Dkenner1/CarConsole/(list of files, cad)

Other CAD files:
Fusion360/ConsoleFrame v17.f3z
Fusion360/MockFrontPanel v5.f3z
