Dkenner1/CarConsole/MultiMediaSystem/Regulator_5V/changelog.txt

Revised Inductor to back side (for upright usage) Rev 1.2
