Dkenner1/CarConsole/MultiMediaSystem/AudioAmp/AudioAmp.kicad_pcb

## KiCad design MultiMediaSystem/AudioAmp/AudioAmp.kicad_pcb (2022-10-20)

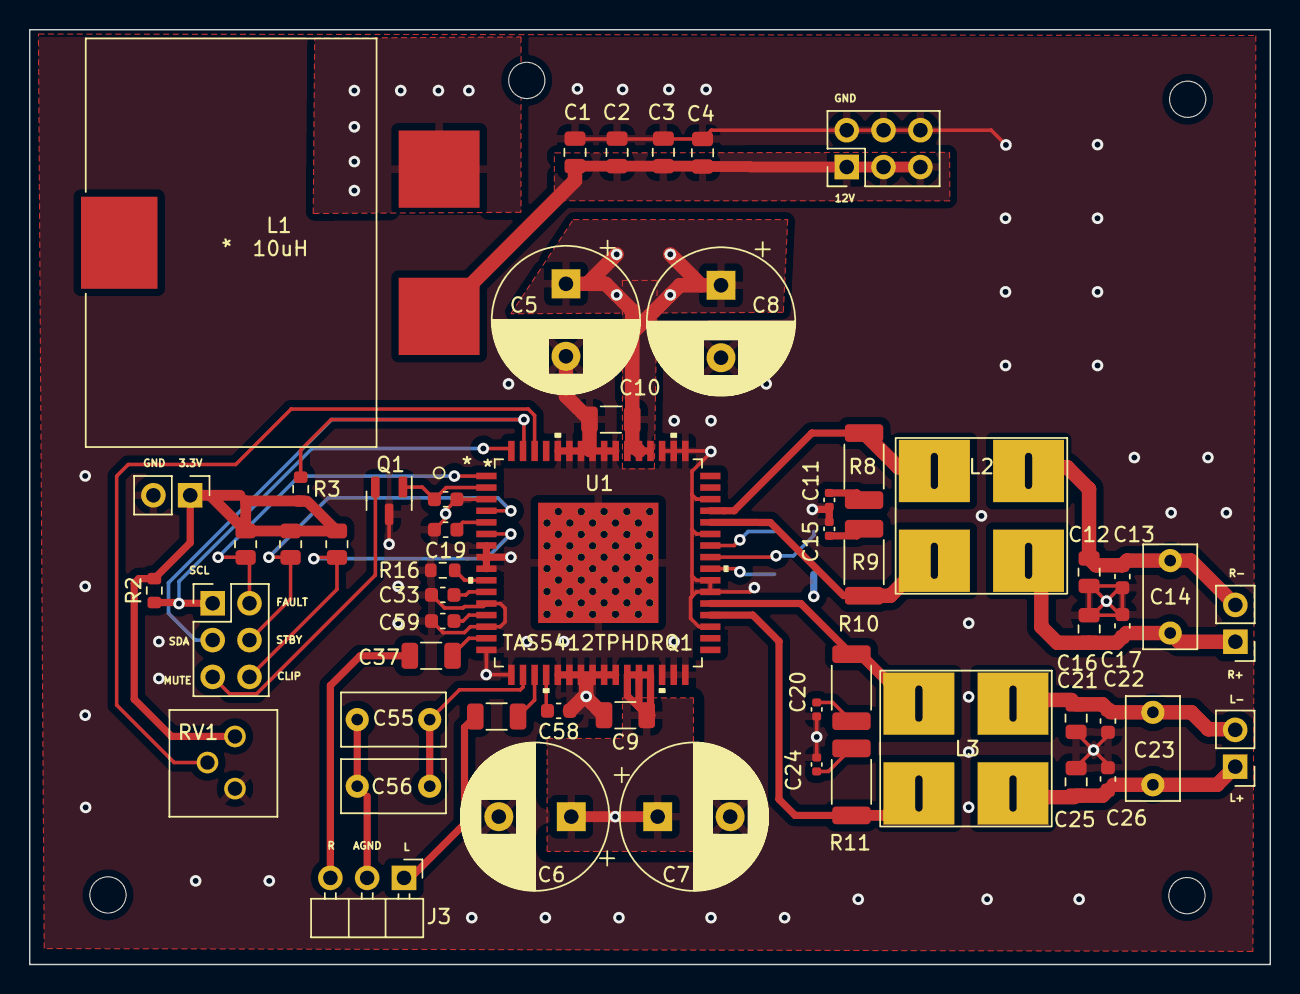
[picture p1: board AudioAmp.kicad_pcb from above]

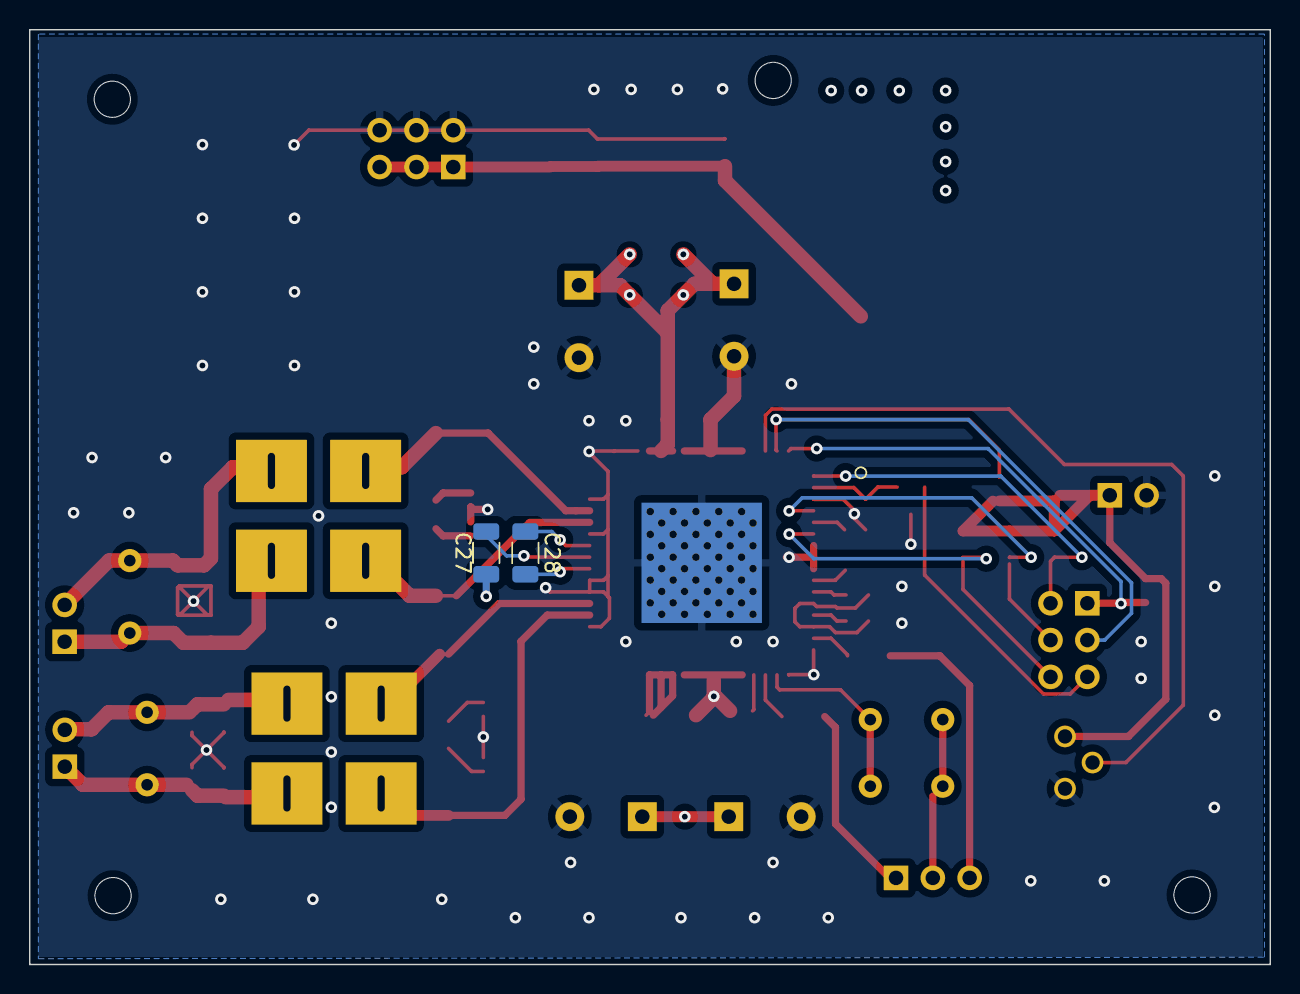
[picture p2: board AudioAmp.kicad_pcb from below]

Board: 4 copper layers, 85.6 x 64.5 mm, 61 parts (2 on the bottom side), 38 nets.

Parts:
C1, C2: 4.7uF; C_0805_2012Metric
C3: 82nF; C_0805_2012Metric
C4: 2.2nF; C_0805_2012Metric
C5, C6, C7, C8: 330uF; CP_Radial_D10.0mm_P5.00mm
C9, C10, C27, C28: 1uF; C_1206_3216Metric
C11, C15, C20, C24: 1nF; C_0402_1005Metric
C12, C16, C21, C25: 470nF; C_0805_2012Metric
C13, C17, C22, C26: 10nF; C_0603_1608Metric
C14, C23, C55, C56: .47uF; C_Rect_L7.0mm_W3.5mm_P5.00mm
C18: 220nF; C_0603_1608Metric
C19, C33, C58, C59: 100nF; C_0603_1608Metric
C37, C39: .47uF; C_1206_3216Metric
H1, H2, H3, H4: MountingHole; MountingHole_2.5mm
J1: Ctrl_pins; PinHeader_2x03_P2.54mm_Vertical
J2: PWR; PinHeader_2x03_P2.54mm_Vertical
J3: AudioIn; PinHeader_1x03_P2.54mm_Horizontal
J4: PULLUP_SRC; PinHeader_1x02_P2.54mm_Vertical
J5: Rspkr_o; PinHeader_1x02_P2.54mm_Vertical
J6: Lspkr_o; PinHeader_1x02_P2.54mm_Vertical
L1: 10uH; SER2918H-103KL
L2, L3: 10uH; JA4575-AL
Q1: q; SOT-23
R2, R3: 4.7K; R_0603_1608Metric
R5, R6, R7: 49.9K; R_0805_2012Metric
R8, R9, R10, R11: 5.6; R_2010_5025Metric
R16: 20k; R_0603_1608Metric
RV1: 50K pot; CT-6EW
U1: TAS5412TPHDRQ1

Connections:
+3V3: J4.1, R2.2, R3.2, R5.2, R6.2, R7.2, RV1.1
+12V: C1.1, C2.1, C3.1, C4.1, J2.1, J2.3, J2.5, L1.1
AudioGND: C55.1, C56.1, J3.2
CLIP_OTW: J1.6, R7.1, U1.6 (*CLIP_OTW)
CP: C27.2, U1.41 (CP)
CPC_TOP: C28.1, U1.42 (CPC_TOP)
CP_BOT: C28.2, U1.40 (CP_BOT)
FAULT: J1.2, R5.1, U1.1 (*FAULT)
GND: C1.2, C2.2, C3.2, C4.2, C5.2, C6.2, C7.2, C8.2, C9.2, C10.2, C11.1, C12.1, C13.1, C15.2, C16.2, C17.2, C18.2, C19.2, C20.1, C21.1, C22.1, C24.2, C25.2, C26.2, C33.2, C58.1, C59.2, J2.2, J2.4, J2.6, J4.2, Q1.3 (S), R16.1, RV1.3, U1.3 (GND), U1.7 (GND), U1.8 (GND), U1.9 (GND), U1.12 (GND), U1.14 (GND), U1.16 (GND), U1.17 (GND), U1.21 (GND), U1.22 (GND), U1.23 (GND), U1.24 (GND), U1.25 (GND), U1.26 (GND), U1.30 (GND), U1.31 (GND), U1.32 (GND), U1.35 (GND), U1.38 (GND), U1.39 (GND), U1.43 (GND), U1.46 (GND), U1.49 (GND), U1.50 (GND), U1.51 (GND), U1.55 (GND), U1.56 (GND), U1.57 (GND), U1.58 (GND), U1.59 (GND), U1.60 (GND), U1.EPAD
I2C_ADDR: RV1.2, U1.62 (I2C_ADDR)
IN1_P: C37.2, U1.15 (IN1_P)
IN2_P: C39.2, U1.19 (IN2_P)
IN_M: C55.2, C56.2, U1.18 (IN_M)
L: C39.1, J3.1
L_o+: C23.2, C25.1, C26.1, J6.1, L3.3
L_o-: C21.2, C22.2, C23.1, J6.2, L3.2
MUTE: J1.5, Q1.2 (G)
MUTE*: C18.1, Q1.1 (D), U1.2 (*MUTE)
unnamed: C11.2, R8.2
unnamed: C15.1, R9.1
unnamed: C19.1, U1.5 (D_BYP)
unnamed: C20.2, R10.2
unnamed: C24.1, R11.1
unnamed: C33.1, U1.11 (A_BYP)
unnamed: C58.2, U1.20 (CM_CAP2)
unnamed: C59.1, U1.13 (CM_CAP1)
unnamed: R16.2, U1.10 (REXT)
OUT1_M: L2.1, R8.1, U1.45 (OUT1_M)
OUT1_P: L2.4, R9.2, U1.44 (OUT1_P)
OUT2_M: L3.1, R10.1, U1.37 (OUT2_M)
OUT2_P: L3.4, R11.2, U1.36 (OUT2_P)
PVDD: C5.1, C6.1, C7.1, C8.1, C9.1, C10.1, C27.1, L1.2, U1.27 (PVDD), U1.28 (PVDD), U1.29 (PVDD), U1.52 (PVDD), U1.53 (PVDD), U1.54 (PVDD)
R: C37.1, J3.3
R_o+: C14.2, C16.1, C17.1, J5.1, L2.3
R_o-: C12.2, C13.2, C14.1, J5.2, L2.2
SCL: J1.1, R2.1, U1.64 (SCL)
SDA: J1.3, R3.1, U1.63 (SDA)
STANDBY: J1.4, R6.1, U1.4 (*STANDBY)
