Dkenner1/CarConsole/MultiMediaSystem/Motherboard/Motherboard.kicad_pcb

## KiCad design MultiMediaSystem/Motherboard/Motherboard.kicad_pcb (2022-10-20)

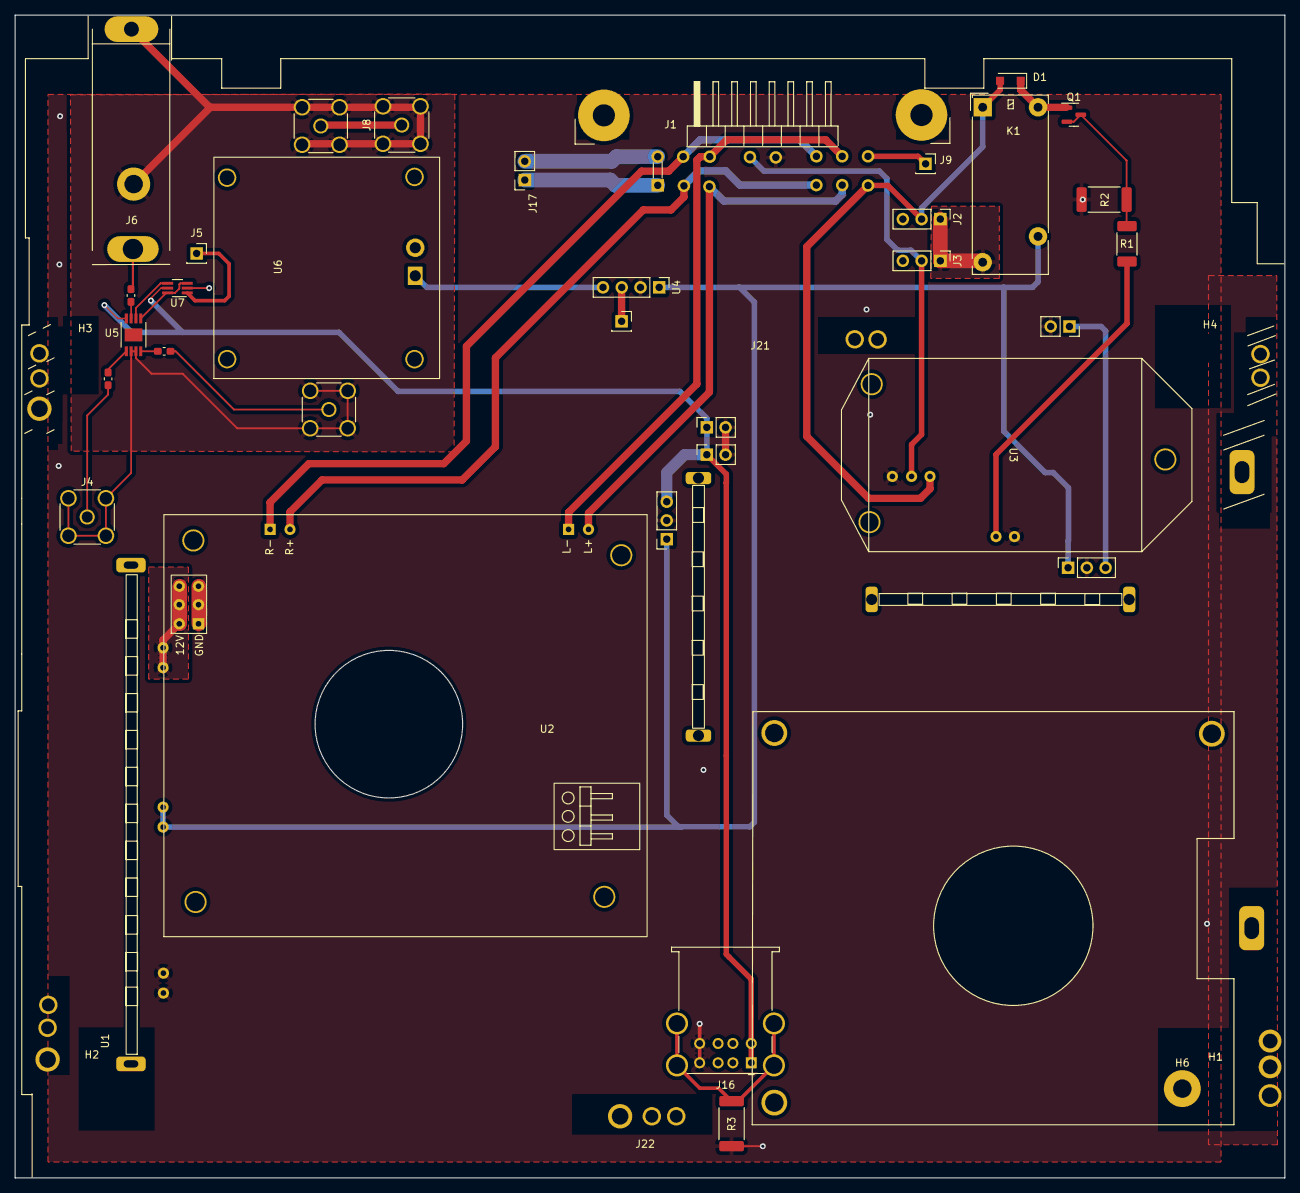
[picture p3: board Motherboard.kicad_pcb from above]

Board: 2 copper layers, 172.1 x 157.6 mm, 42 parts (0 on the bottom side), 32 nets.

Parts:
C1, C2, C3: 10uF; C_0603_1608Metric_Pad1.08x0.95mm_HandSolder
D1: FS1B; D_SOD-123F
H1, H2, H3, H4: MountingHole; RectangleSlot
H5, H6, H7, H8: DAC_mount; MountingHole_2.5mm_Pad
J1: Wire Harness; HeadUnit_Conn
J2: Vmem Jumper; PinHeader_1x03_P2.54mm_Vertical
J3: Vacc_jumper; PinHeader_1x03_P2.54mm_Vertical
J4: RF_RX; SMA_Amphenol_132134_Vertical
J5: RF_CTRL; PinSocket_1x01_P2.54mm_Vertical
J6: AntennaExternal; SubaruRadioJack
J8: RF_TX; SMA_Amphenol_132134_Vertical
J9: AntennaPwr_Conn; PinSocket_1x01_P2.54mm_Vertical
J10: RF_EN; PinSocket_1x01_P2.54mm_Vertical
J14: 5V_1; PinSocket_1x02_P2.54mm_Vertical
J15: RPI_Buck; 5V_Reg_Footprint_VertMnt
J16: AUSB2-4599; USB_A_Wuerth_61400826021_Horizontal_Stacked
J17: Illum/Dim; PinSocket_1x02_P2.54mm_Vertical
J18: 5V_2; PinSocket_1x02_P2.54mm_Vertical
J19: GP_Buck; 5V_Reg_Footprint_VertMnt
J20: 5V_3; PinSocket_1x02_P2.54mm_Vertical
J21: Motherboard bracket; MotherBoard_Bracket_2
J22: Motherboard bracket; MotherBoard_Bracket_1
K1: ADW1112HTW; Relay_1P1T_NO_10x24x18.8mm_Panasonic_ADW11xxxxW_THT
Q1: T2N7002BK,LM; SOT-23
R1: RMCP2010FT470R; R_2010_5025Metric_Pad1.40x2.65mm_HandSolder
R2: RC2512JK-0747KL; R_2512_6332Metric_Pad1.40x3.35mm_HandSolder
R3: HCJ2512ZT0R00; R_2512_6332Metric_Pad1.40x3.35mm_HandSolder
U1: AudioAmp_PS
U2: AudioAmp
U3: PowerSupplyCtrl; PS_Controller
U4: RadioRegulator; PinHeader_1x04_P2.54mm_Vertical
U5: HMC784AMS8GETR
U6: RadioAmp
U7: SN74LVC2G06QDCKRQ1; SOT-363_SC-70-6_Handsoldering

Connections:
5V: J14.1, J15.3
5V_GP: J16.1 (VBUS1), J16.5 (VBUS2), J18.1, J19.3, J20.1, U5.4 (VDD), U7.5 (VCC)
8V: U4.4 (Vradio), U6.1 (Vsrc)
Antenna: C1.1, J6.1 (In)
Antenna_Pwr: J1.14, J9.1
AudioPwr: U1.3 (Vout), U2.1 (12V)
Dim: J1.7, J17.2
FrontSpkr_L+: J1.3, J1.5, U2.5 (L+)
FrontSpkr_L-: J1.9, J1.13, U2.6 (L-)
FrontSpkr_R+: J1.2, J1.4, U2.3 (R+)
FrontSpkr_R-: J1.8, J1.12, U2.4 (R-)
GND: J1.11, J14.2, J15.2, J16.4 (GND1), J16.8 (GND2), J18.2, J19.2, J20.2, R2.1, R3.1, U1.2 (GND), U2.2 (GND), U3.3 (GND), U4.2 (GND), U6.2 (GND), U7.2 (GND)
Illum: J1.1, J17.1
unnamed: C1.2, U5.3 (RFC)
unnamed: C2.1, U5.5 (RF1)
unnamed: C3.1, U5.8 (RF2)
unnamed: D1.1 (K), K1.6, Q1.1 (D)
unnamed: J16.9 (Shield), R3.2
unnamed: Q1.2 (G), Q1.3 (S), R1.2, R2.2
RELAY: R1.1, U3.6 (SWITCH)
RF_A: U5.1 (A), U7.3 (2A), U7.6 (1Y)
RF_ATX: C3.2, U6.5 (out)
RF_B: U5.2 (B), U7.4 (2Y)
RF_CTL: J5.1, U7.1 (1A)
RF_RX: C2.2, J4.1 (In)
RF_TX: J8.1 (In), U6.3 (in)
RF_gnd: J4.2 (Ext), J6.2 (Ext), J8.2 (Ext), U5.6 (GND), U5.7 (GND), U6.4 (in_gnd), U6.6 (out_gnd)
Radio_EN: J10.1, U4.3 (EN)
Vacc: J1.10, J3.2, U3.2 (Vmes)
Vdd: J2.1, J3.1, K1.3
Vmem: D1.2 (A), J1.6, J2.2, K1.1, U3.1 (Vin)
Vsrc: J15.1, J19.1, K1.5, U1.1 (Vin), U4.1 (Vsrc)
