Dkenner1/CarConsole/MultiMediaSystem/StereoPS/StereoPS_SMD_REV/StereoPS_SMD_REV.kicad_pcb

## KiCad design MultiMediaSystem/StereoPS/StereoPS_SMD_REV/StereoPS_SMD_REV.kicad_pcb (2022-10-20)

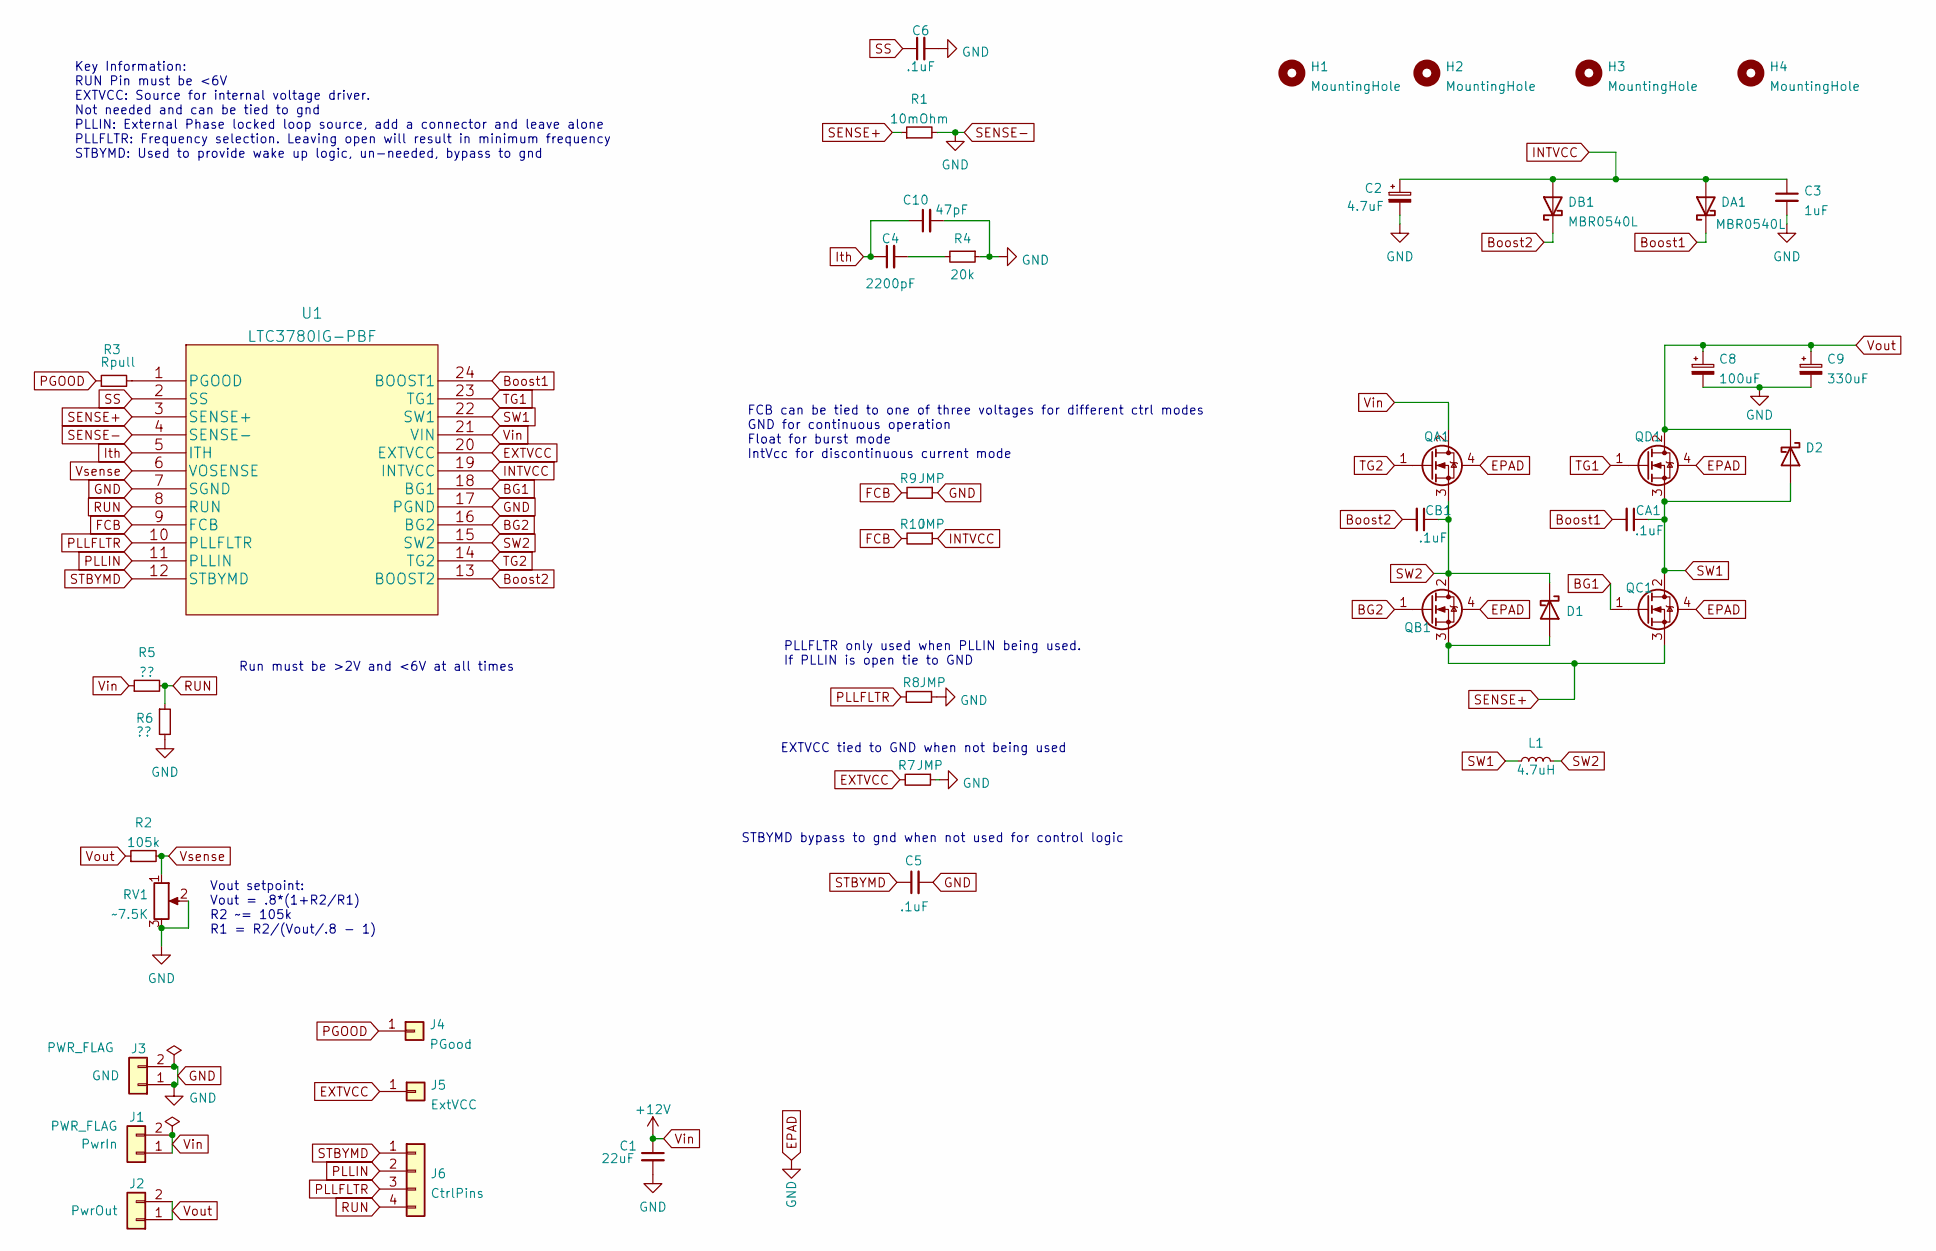
[picture p4: schematic StereoPS_SMD_REV.kicad_sch, LTC3780 Audio Amplifier Voltage Regulator]

Parts:
C1: 22uF; C_1206_3216Metric_Pad1.33x1.80mm_HandSolder
C2: 4.7uF; C_0805_2012Metric_Pad1.18x1.45mm_HandSolder
C3: 1uF; C_1206_3216Metric_Pad1.33x1.80mm_HandSolder
C4: 2200pF; C_0805_2012Metric_Pad1.18x1.45mm_HandSolder
C5, C6: .1uF; C_0603_1608Metric_Pad1.08x0.95mm_HandSolder
C8: 100uF; CP_Radial_D8.0mm_P3.50mm
C9: 330uF; CP_Radial_D10.0mm_P5.00mm
C10: 47pF; C_0603_1608Metric_Pad1.08x0.95mm_HandSolder
CA1: .1uF; C_0603_1608Metric_Pad1.08x0.95mm_HandSolder
CB1: .1uF; C_0603_1608Metric_Pad1.08x0.95mm_HandSolder
D1: SS34-E3; D_SOD-123
D2: SS32-E3; D_SOD-123
DA1: MBR0540L; D_SOD-123
DB1: MBR0540L; D_SOD-123
H1, H2, H3, H4: MountingHole; MountingHole_2.5mm
J1: PwrIn; PinHeader_1x02_P2.54mm_Horizontal
J2: PwrOut; PinHeader_1x02_P2.54mm_Horizontal
J3: GND; PinHeader_1x02_P2.54mm_Horizontal
J4: PGood; PinSocket_1x01_P2.54mm_Vertical
J5: ExtVCC; PinSocket_1x01_P2.54mm_Vertical
J6: CtrlPins; PinSocket_1x04_P2.54mm_Vertical
L1: 4.7uH; L_12x12mm_H8mm
QA1: RX3G07CGNC16; MSOP-8-1EP_3x3mm_P0.65mm_EP1.73x1.85mm
QB1: RX3G07CGNC16; MSOP-8-1EP_3x3mm_P0.65mm_EP1.73x1.85mm
QC1: RX3G07CGNC16; MSOP-8-1EP_3x3mm_P0.65mm_EP1.73x1.85mm
QD1: RX3G07CGNC16; MSOP-8-1EP_3x3mm_P0.65mm_EP1.73x1.85mm
R1: 10mOhm; R_0402_1005Metric_Pad0.72x0.64mm_HandSolder
R2: 105k; R_1206_3216Metric_Pad1.30x1.75mm_HandSolder
R3: Rpull; R_0805_2012Metric_Pad1.20x1.40mm_HandSolder
R4: 20k; R_1206_3216Metric_Pad1.30x1.75mm_HandSolder
R5, R6: ??; R_0805_2012Metric_Pad1.20x1.40mm_HandSolder
R7, R8, R9, R10: JMP; R_0805_2012Metric_Pad1.20x1.40mm_HandSolder
RV1: ~7.5K; CT-6EW
U1: LTC3780IG-PBF

Connections:
BG1: QC1.1 (G), U1.18 (BG1)
BG2: QB1.1 (G), U1.16 (BG2)
Boost1: CA1.2, DA1.1 (K), U1.24 (BOOST1)
Boost2: CB1.2, DB1.1 (K), U1.13 (BOOST2)
EPAD: C1.2, C2.2, C3.2, C5.2, C6.2, C8.2, C9.2, C10.2, J3.1, J3.2, QA1.4 (EPAD), QB1.4 (EPAD), QC1.4 (EPAD), QD1.4 (EPAD), R1.2, R4.1, R6.2, R7.1, R8.1, R9.1, RV1.2, RV1.3, U1.4 (SENSE-), U1.7 (SGND), U1.17 (PGND)
EXTVCC: J5.1, R7.2, U1.20 (EXTVCC); also elsewhere on the board
FCB: R9.2, R10.2, U1.9 (FCB)
INTVCC: C2.1, C3.1, DA1.2 (A), DB1.2 (A), R10.1, U1.19 (INTVCC)
Ith: C4.1, C10.1, U1.5 (ITH)
unnamed: C4.2, R4.2
unnamed: R3.2, U1.1 (PGOOD)
PGOOD: J4.1, R3.1
PLLFLTR: J6.3, R8.2, U1.10 (PLLFLTR)
PLLIN: J6.2, U1.11 (PLLIN)
RUN: J6.4, R5.2, R6.1, U1.8 (RUN)
SENSE+: D1.2 (A), QB1.3 (S), QC1.3 (S), R1.1, U1.3 (SENSE+)
SS: C6.1, U1.2 (SS)
STBYMD: C5.1, J6.1, U1.12 (STBYMD)
SW1: CA1.1, D2.2 (A), L1.1, QC1.2 (D), QD1.3 (S), U1.22 (SW1)
SW2: CB1.1, D1.1 (K), L1.2, QA1.3 (S), QB1.2 (D), U1.15 (SW2)
TG1: QD1.1 (G), U1.23 (TG1)
TG2: QA1.1 (G), U1.14 (TG2)
Vin: C1.1, J1.1, J1.2, QA1.2 (D), R5.1, U1.21 (VIN)
Vout: C8.1, C9.1, D2.1 (K), J2.1, J2.2, QD1.2 (D), R2.1
Vsense: R2.2, RV1.1, U1.6 (VOSENSE)

Notes on the sheet:
Key Information: RUN Pin must be <6V EXTVCC: Source for internal voltage driver. Not needed and can be tied to gnd PLLIN: External Phase locked loop source, add a connector and leave alone PLLFLTR: Frequency selection. Leaving open will result in minimum frequency STBYMD: Used to provide wake up lo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
EXTVCC tied to GND when not being used
Run must be >2V and <6V at all times
FCB can be tied to one of three voltages for different ctrl modes GND for continuous operation Float for burst mode IntVcc for discontinuous current mode
Vout setpoint: Vout = .8*(1+R2/R1) R2 ~= 105k R1 = R2/(Vout/.8 - 1)
PLLFLTR only used when PLLIN being used. If PLLIN is open tie to GND
STBYMD bypass to gnd when not used for control logic

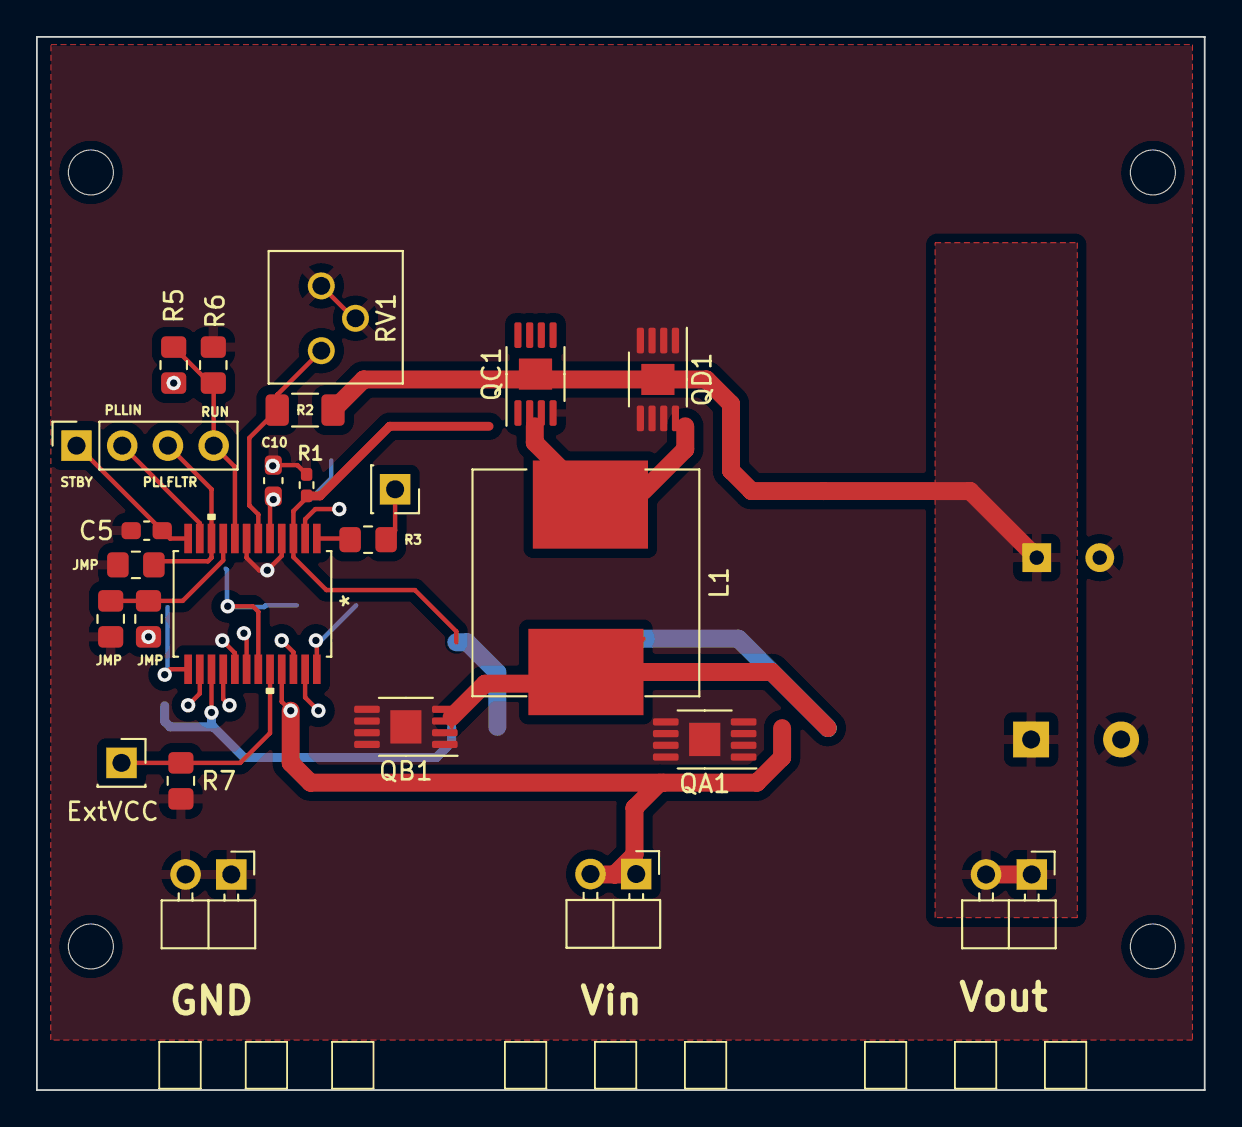
[picture p5: board StereoPS_SMD_REV.kicad_pcb from above]

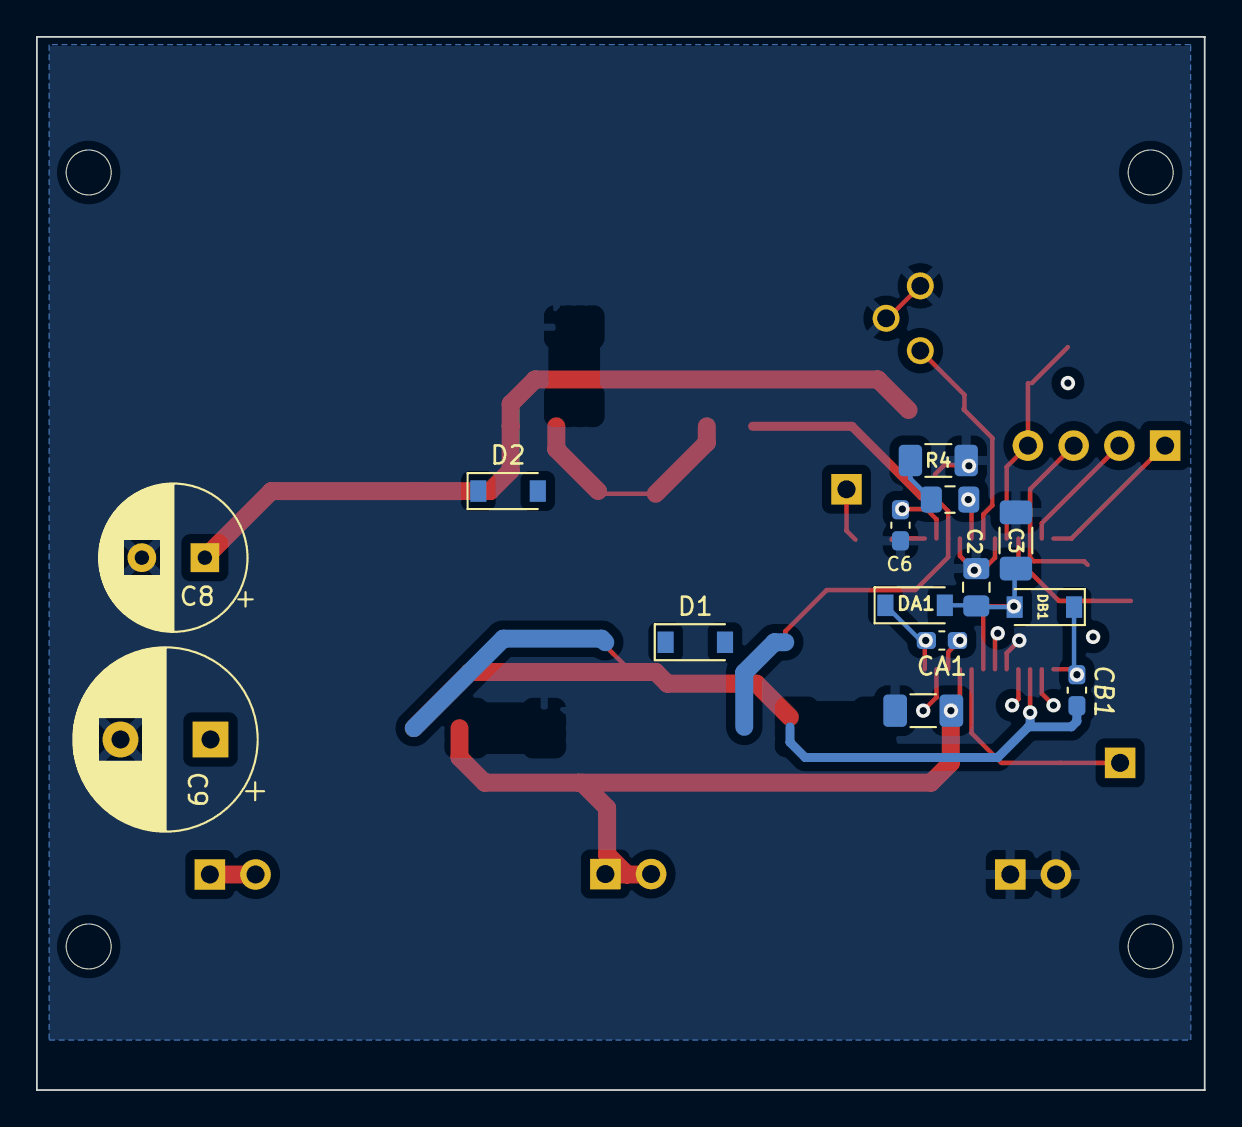
[picture p6: board StereoPS_SMD_REV.kicad_pcb from below]

Board: 4 copper layers, 64.9 x 58.5 mm, 42 parts (14 on the bottom side), 25 nets.

Other parts of the board:
ExtVCC: ExtVCC; PinSocket_1x01_P2.54mm_Vertical

Their connections:
EXTVCC: ExtVCC.1; also elsewhere on the board
