Dkenner1/CarConsole/MultiMediaSystem/StereoPS/StereoPS.kicad_pcb

## KiCad design MultiMediaSystem/StereoPS/StereoPS.kicad_pcb (2022-10-20)

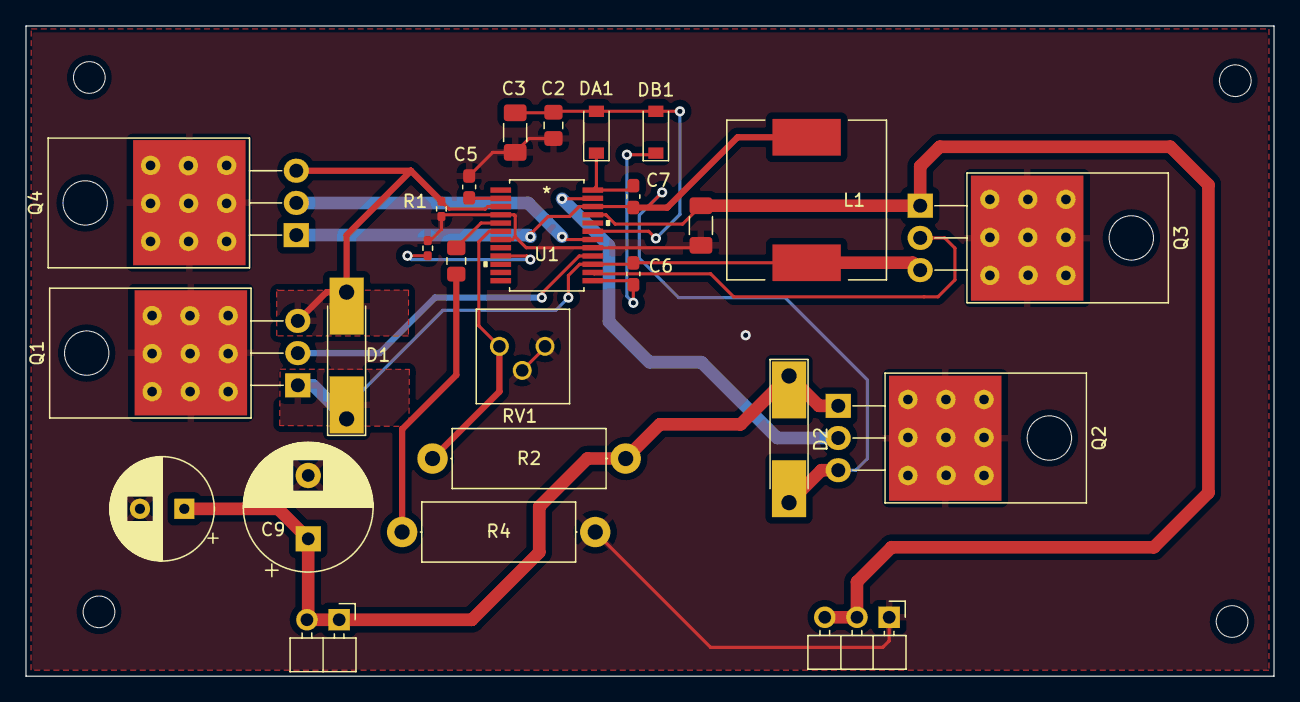
[picture p7: board StereoPS.kicad_pcb from above]

Board: 2 copper layers, 98.5 x 51.3 mm, 30 parts (0 on the bottom side), 18 nets.

Parts:
C1: 22uF; C_1206_3216Metric_Pad1.33x1.80mm_HandSolder
C2: 4.7uF; C_0805_2012Metric_Pad1.18x1.45mm_HandSolder
C3: 1uF; C_1206_3216Metric_Pad1.33x1.80mm_HandSolder
C4: 2200pF; C_0805_2012Metric_Pad1.18x1.45mm_HandSolder
C5, C6, C7: .1uF; C_0603_1608Metric_Pad1.08x0.95mm_HandSolder
C8: 100uF; CP_Radial_D8.0mm_P3.50mm
C9: 330uF; CP_Radial_D10.0mm_P5.00mm
D1: SS34-E3; D_MELF-RM10_Universal_Handsoldering
D2: SS32-E3; D_MELF-RM10_Universal_Handsoldering
DA1: MBR0540L; D_SOD-123
DB1: MBR0540L; D_SOD-123
H1, H2, H3, H4: MountingHole; MountingHole_2.5mm
J1: PwrIn; PinHeader_1x03_P2.54mm_Horizontal
J2: PwrOut; PinHeader_1x02_P2.54mm_Horizontal
L1: 4.7uH; L_12x12mm_H8mm
Q1, Q2, Q3, Q4: RX3G07CGNC16; TO-220-3_Horizontal_TabDown_Thermal
R1: 10mOhm; R_0402_1005Metric_Pad0.72x0.64mm_HandSolder
R2: 105k; R_Axial_DIN0414_L11.9mm_D4.5mm_P15.24mm_Horizontal
R3: 0Ohm; R_0402_1005Metric_Pad0.72x0.64mm_HandSolder
R4: 20k; R_Axial_DIN0414_L11.9mm_D4.5mm_P15.24mm_Horizontal
RV1: ~7.5K; CT-6EW
U1: LTC3780IG-PBF

Connections:
BG1: Q4.2 (G), U1.18 (BG1)
BG2: Q1.2 (G), U1.16 (BG2)
Boost1: C7.2, DA1.1 (K), U1.24 (BOOST1)
Boost2: C6.2, DB1.1 (K), U1.13 (BOOST2)
FCB: R3.2, U1.9 (FCB)
GND: C1.2, C2.2, C3.2, C5.2, C8.2, C9.2, J1.1, Q1.4 (EPAD), Q2.4 (EPAD), Q3.4 (EPAD), Q4.4 (EPAD), R1.2, R3.1, R4.1, RV1.2, RV1.3, U1.4 (SENSE-), U1.7 (SGND), U1.17 (PGND)
INTVCC: C2.1, C3.1, DA1.2 (A), DB1.2 (A), U1.19 (INTVCC)
Ith: C4.1, U1.5 (ITH)
unnamed: C4.2, R4.2
SENSE+: D1.2 (A), Q1.3 (S), Q4.3 (S), R1.1, U1.3 (SENSE+)
SS: C5.1, U1.2 (SS)
SW1: C7.1, D2.2 (A), L1.1, Q2.3 (S), Q4.1 (D), U1.22 (SW1)
SW2: C6.1, D1.1 (K), L1.2, Q1.1 (D), Q3.3 (S), U1.15 (SW2)
TG1: Q2.2 (G), U1.23 (TG1)
TG2: Q3.2 (G), U1.14 (TG2)
Vin: C1.1, J1.2, J1.3, Q3.1 (D), U1.21 (VIN)
Vout: C8.1, C9.1, D2.1 (K), J2.1, J2.2, Q2.1 (D), R2.2
Vsense: R2.1, RV1.1, U1.6 (VOSENSE)
