Dkenner1/CarConsole/MultiMediaSystem/Regulator_5V/Regulator_5V.kicad_pcb

## KiCad design MultiMediaSystem/Regulator_5V/Regulator_5V.kicad_pcb (2022-10-20)

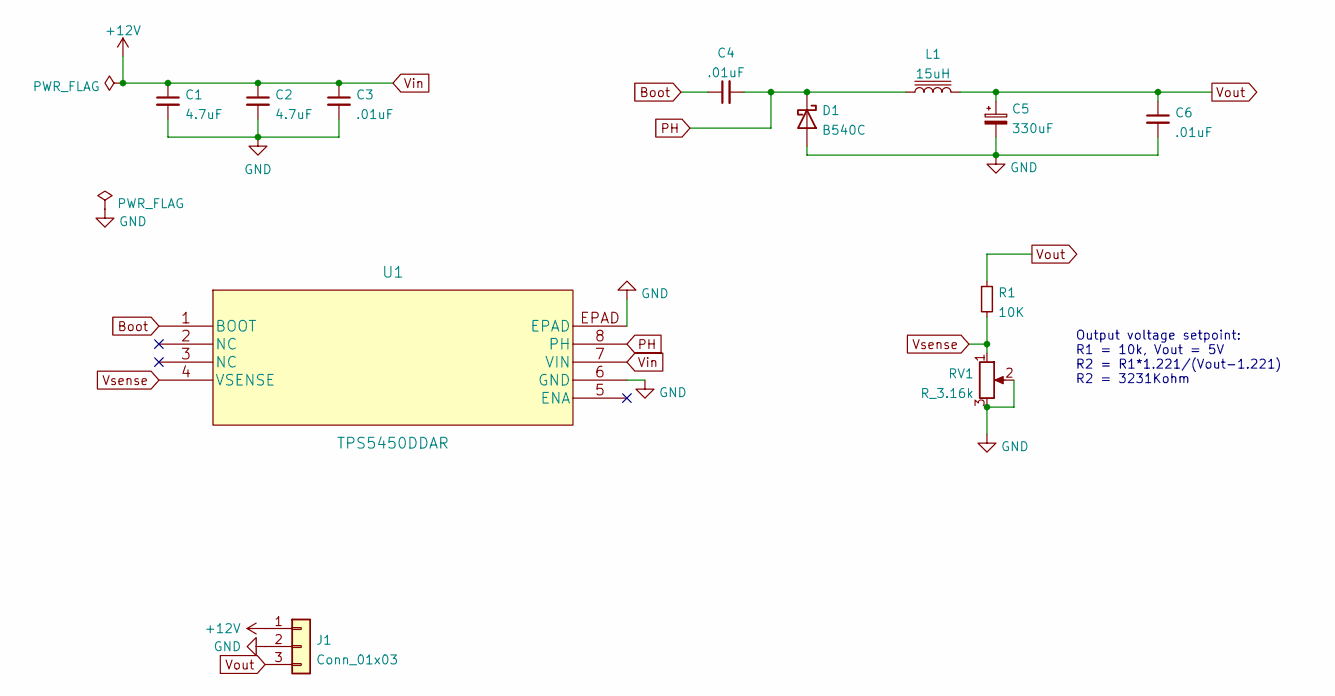
[picture p8: schematic Regulator_5V.kicad_sch, 5V, 5A Buck Regulator]

Parts:
C1, C2: 4.7uF; C_0805_2012Metric_Pad1.18x1.45mm_HandSolder
C3, C4, C6: .01uF; C_0603_1608Metric_Pad1.08x0.95mm_HandSolder
C5: 330uF; CP_EIA-7343-15_Kemet-W_Pad2.25x2.55mm_HandSolder
D1: B540C; D_MELF_Handsoldering
J1: Conn_01x03; PinHeader_1x03_P2.54mm_Horizontal
L1: 15uH; SER2918H-103KL
R1: 10K; R_0805_2012Metric_Pad1.20x1.40mm_HandSolder
RV1: R_3.16k; GF063P1
U1: TPS5450DDAR

Connections:
Boot: C4.1, U1.1 (BOOT)
GND: C1.2, C2.2, C3.2, C5.2, C6.2, D1.2 (A), J1.2, RV1.2, RV1.3, U1.6 (GND), U1.EPAD
PH: C4.2, D1.1 (K), L1.1, U1.8 (PH)
Vin: C1.1, C2.1, C3.1, J1.1, U1.7 (VIN)
Vout: C5.1, C6.1, J1.3, L1.2, R1.1
Vsense: R1.2, RV1.1, U1.4 (VSENSE)

Notes on the sheet:
Output voltage setpoint: R1 = 10k, Vout = 5V R2 = R1*1.221/(Vout-1.221) R2 = 3231Kohm

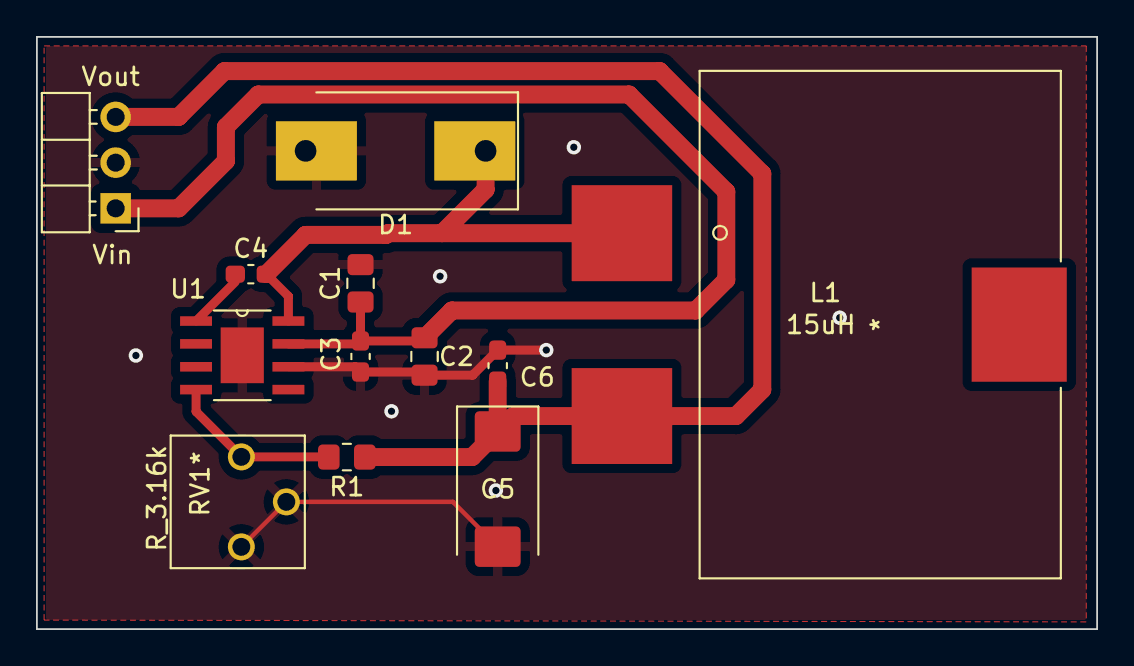
[picture p9: board Regulator_5V.kicad_pcb from above]

Board: 2 copper layers, 58.9 x 32.9 mm, 12 parts (0 on the bottom side), 6 nets.
