Dkenner1/CarConsole/MultiMediaSystem/PS_controller/PS_controller.kicad_pcb

## KiCad design MultiMediaSystem/PS_controller/PS_controller.kicad_pcb (2022-04-29, an earlier design)

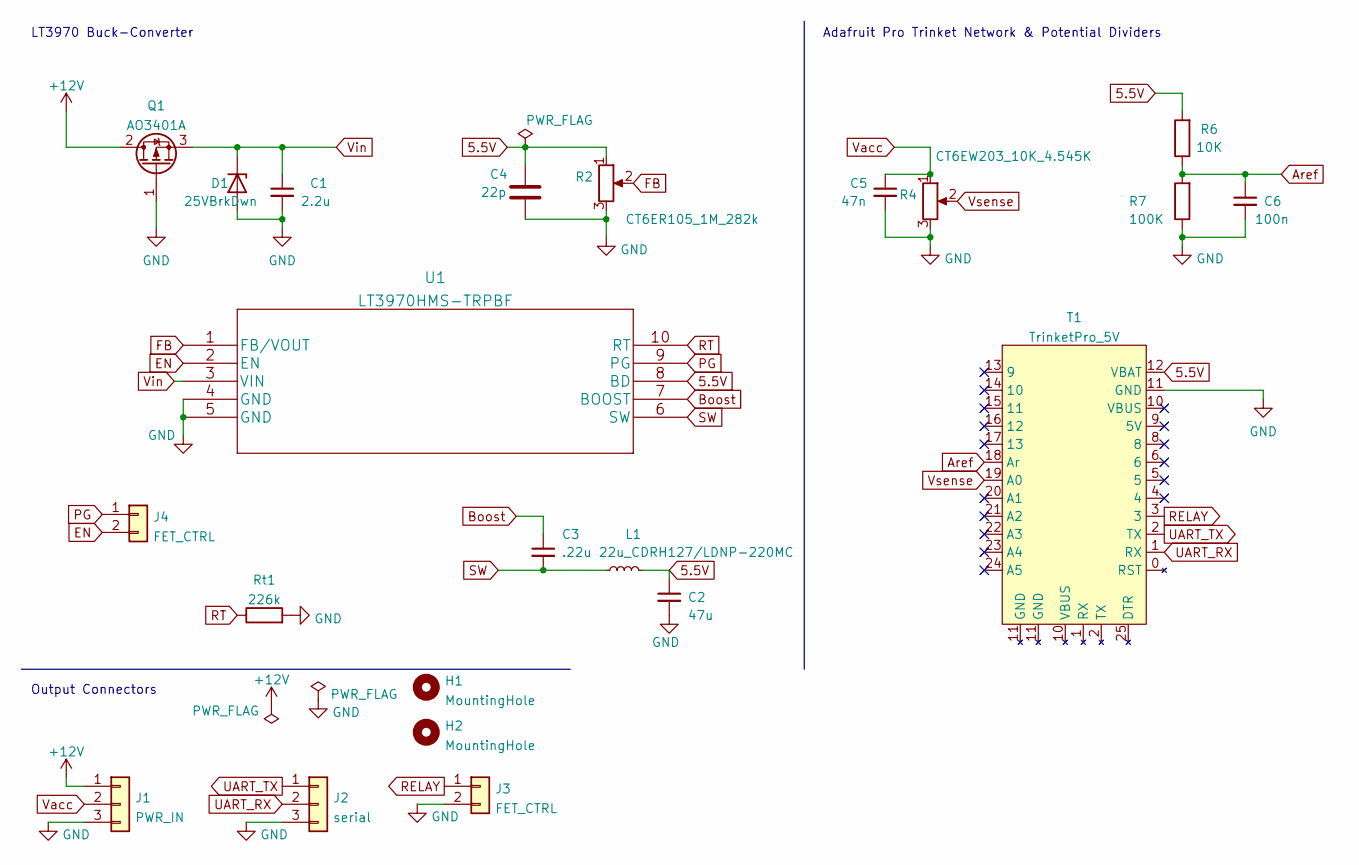
[picture p10: schematic PS_controller.kicad_sch, Power Controller]

Parts:
C1: 2.2u; C_0805_2012Metric_Pad1.18x1.45mm_HandSolder
C2: 47u; C_1206_3216Metric_Pad1.33x1.80mm_HandSolder
C3: .22u; C_0603_1608Metric_Pad1.08x0.95mm_HandSolder
C4: 22p; C_0805_2012Metric_Pad1.18x1.45mm_HandSolder
C5: 47n; C_0805_2012Metric_Pad1.18x1.45mm_HandSolder
C6: 100n; C_0.64x0.4_Handsolder
D1: 25VBrkDwn; D_SOD-123
H1, H2: MountingHole; MountingHole_2.5mm
J1: PWR_IN; PinSocket_1x03_P2.54mm_Vertical
J2: serial; PinSocket_1x03_P2.54mm_Vertical
J3, J4: FET_CTRL; PinSocket_1x02_P2.54mm_Vertical
L1: 22u_CDRH127/LDNP-220MC; L_12x12mm_H8mm
Q1: AO3401A; SOT-23
R2: CT6ER105_1M_282k; GF063P1
R4: CT6EW203_10K_4.545K; CT-6EW
R6: 10K; R_0603_1608Metric_Pad0.98x0.95mm_HandSolder
R7: 100K; R_1206_3216Metric_Pad1.30x1.75mm_HandSolder
Rt1: 226k; R_0402_1005Metric_Pad0.72x0.64mm_HandSolder
T1: TrinketPro_5V; TrinketPro5V
U1: LT3970HMS-TRPBF

Connections:
5.5V: C2.1, C4.1, L1.2, R2.1, R6.2, T1.12 (VBAT), U1.8 (BD)
+12V: J1.1, Q1.2 (D)
Aref: C6.1, R6.1, R7.2, T1.18 (Ar)
Boost: C3.1, U1.7 (BOOST)
EN: J4.2, U1.2 (EN)
FB: R2.2, U1.1 (FB/VOUT)
GND: C1.2, C2.2, C4.2, C5.2, C6.2, D1.2 (A), J1.3, J2.3, J3.2, Q1.1 (G), R2.3, R4.3, R7.1, Rt1.2, T1.11 (GND), U1.4 (GND), U1.5 (GND)
PG: J4.1, U1.9 (PG)
RELAY: J3.1, T1.3
RT: Rt1.1, U1.10 (RT)
SW: C3.2, L1.1, U1.6 (SW)
UART_RX: J2.2, T1.1 (RX)
UART_TX: J2.1, T1.2 (TX)
Vacc: C5.1, J1.2, R4.1
Vin: C1.1, D1.1 (K), Q1.3 (S), U1.3 (VIN)
Vsense: R4.2, T1.19 (A0)

Notes on the sheet:
Output Connectors
Adafruit Pro Trinket Network & Potential Dividers
LT3970 Buck-Converter

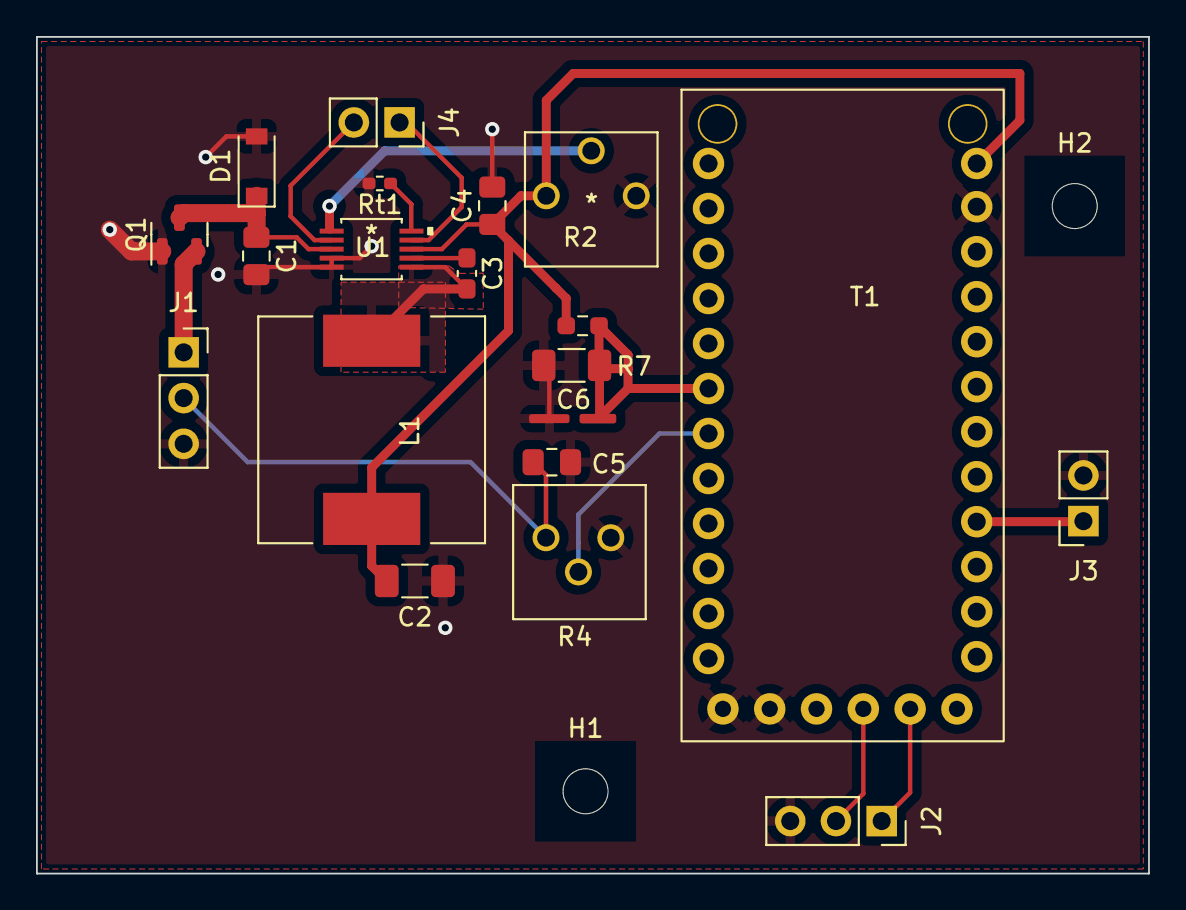
[picture p11: board PS_controller.kicad_pcb from above]

Board: 2 copper layers, 61.8 x 46.5 mm, 22 parts (0 on the bottom side), 16 nets.
