Dkenner1/CarConsole/(commit log)

2022-04-29 Removed Extra Files
    [CarConsole.kicad_pcb, CarConsole.sch, ConsoleFrame v17.f3z, MockFrontPanel v5.f3z]
2022-05-05 Adjusted Motherboard Pinouts
    Motherboard pinout's were slightly off. This corrects that problem.
    [AudioAmp.kicad_pcb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]
2022-10-20 Updated all designs
    [AudioAmp.csv, AudioAmp.kicad_pcb, AudioAmp.kicad_sch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]
